kirikristof/R2D2-model/R2-D2.png

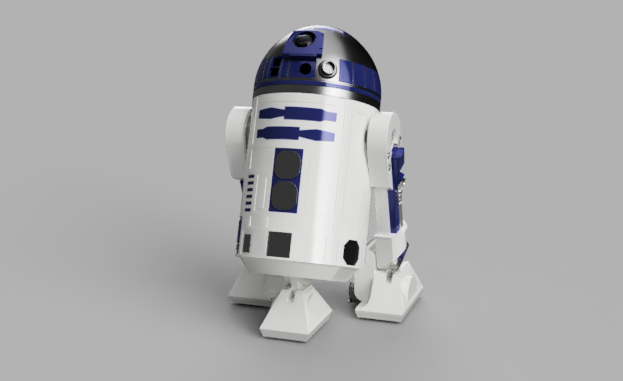
R2-D2.png
