kirikristof/R2D2-model/BOM.csv

Item Name | Qty | Price (total) (USD) | Source | Notes | Total (tax + shipping) | Link
PETG Basic white filament | 3kg | $39,87 | Bambu Lab | Filament for the main body and decorative elemets |  | https://us.store.bambulab.com/products/petg-basic?id=703099511296864281
3D printer |  |  | Borrowed | 3D printing the R2-D2 body parts
Neodimium magnet 5 x 2 mm | 40 | $10,43 | eMAG | For conecting panels |  | https://www.emag.ro/set-magneti-rotunzi-puternici-neodim-5x2-mm-argintii-20-buc-ebn2481/pd/D2R1YT3BM/
M4 x 14 mm Screw | 20 | $4,00 | Local Hardware Shop | Fastening leg joints, body, stepper motor mount and the V-groove
M4 Hex Nut | 28 |  |  | Fastening leg joints and the body
M4 x 25 mm Screw | 2 |  |  | Fastening the stepper motor
M6 x 20 mm Screw | 5 |  |  | Fastening the feet and ankles
M6 x 35 mm Screw | 2 |  |  | Fastening the feet and ankles
M6 Hex Nut | 7 |  |  | Fastening the feet and ankles
M4 Set Screw | 2 |  |  | Fastening leg wheel
M3 x 10 mm Screw | 4 |  |  | Securing the JGA motors
M3 x 16 mm Screw | 8 |  |  | Fastening the motor mount
M3 Hex Nut | 8 |  |  | Fastening the motor mount
M5 x 35 or 40 mm Screw | 6 |  |  | Fastening the Shoulders
M5 Hex Nut | 6 |  |  | Fastening the Shoulders
M4 x 12 mm Screw | 6
M3 x 10 mm Screw | 6 |  |  | Fastening the internal gear
Silver Spray Paint | 1 | Owned |  | For painting
Blue Spray Paint | 1 | $2,00 | Local Hardware Shop
Black Spray Paint | 1 | $2,00
JGA25-370 Gearmotor (6V, 176 rpm) | 2 | $21,16 | Optimus Digital | Main drive motor for legs
Raspberry Pi Pico WH RP2040 | 1 | $13,85 | eMAG | Main microcontroller for the motors and LEDs |  | https://www.emag.ro/raspberry-pi-pico-wh-rp2040-cu-wifi-si-pini-prelipiti-ai2442/pd/D9JM652BM/
28BYJ-48 Stepper Motor | 1 | $4,29 | They were in a bundle | Dome rotation |  | https://www.optimusdigital.ro/en/stepper-motors/2487-step-by-step-28byj048-5v-motor-and-uln2003-driver-green-.html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
ULN2003 Stepper motor driver | 1
Ceramic Capacitor | 2 | $2,61 | eMAG | Prevent electrical noise and sparks |  | https://www.emag.ro/condensator-ceramic-0-1uf-50v-x7r-vishay-k104k10x7rf5uh5-t275622/pd/DY9D7KYBM/
LEDs | 2 | Owned | Owned | Light in the night (Status LEDs for the dome)
Breadboard HQ (830 points) | 1 | $2,40 | Optimus Digital | Connecting electronics |  | https://www.optimusdigital.ro/en/breadboards/8-breadboard-hq-830-points.html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
Male to Female Jumper Wires | 1 Bundle | $5,52 | Optimus Digital | Connecting electronics |  | https://www.optimusdigital.ro/en/wires-with-connectors/12466-male-to-female-jumper-wires-40-pin-40cm.html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
Male to Male Jumper Wires | 1 Bundle | $1,20 | Optimus Digital |  |  | https://www.optimusdigital.ro/en/wires-with-connectors/889-set-fire-tata-tata-10p-20-cm.html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
Female to Female Jumper Wires | 40 | $2,70 | Optimus Digital |  |  | https://www.optimusdigital.ro/en/wires-with-connectors/627-fir-mama-mama-8p-de-20-cm.html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
TB6612FNG Dual Motor Driver (1 A) | 1 | $6,00 | Optimus Digital | Routes power to the drive motors so the Pico can control them |  | https://www.optimusdigital.ro/en/brushed-motor-drivers/134-tb6612fng-dual-motor-driver-1-a.html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
18650 Li-Ion Batteries | 2 | Owned | Owned | Main rechargeable power source
Li-Ion Battery Holder | 1 | $3,38 | Sierra. Ro | Housing and connecting the 18650 batteries |  | https://www.sierra.ro/cumpara/suport-acumulator-liion-format-18650-2-celule-in-serie-2150
AAA Alkaline battery | 4 | Owned | Owned | Main power source of the stepper motor
Resistor Kit 250 pcs | 1 (enough for a liftime) | $3,60 | Optimus Digital |  |  | https://www.optimusdigital.ro/en/resistors/10928-250-pcs-plusivo-resistor-kit.html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
Small Switch | 1 | Owned | Owned | Toggle electricity to leg motors
BMS PCB | 1 | $5,57 | eMAG | Prevents overcharging and overdischarging, and balances cell voltages |  | https://www.emag.ro/modul-echilibrare-si-protectie-la-incarcare-baterii-18650-20-a-2s-ai513-s176/pd/DJZKR7MBM/
Battery Holder for Small Batteries |  | Owned | Owned | Housing the AAA batteries
Assembly Consumables & Tools | 1 | Owned | Owned | Glue, sandpaper, Velcro Tape for the removable parts
Airsoft BBs / Steel bearing balls | 50-100 | Owned | Owned | Tested in V-groove for head bearing. Removed later because the mechanism turned smoother without them.
Total Price (USD): | $130,58 |  |  |  | $150,58
