kirikristof/R2D2-model/CAD/CAD_Body_Frame/Body_Frame.step

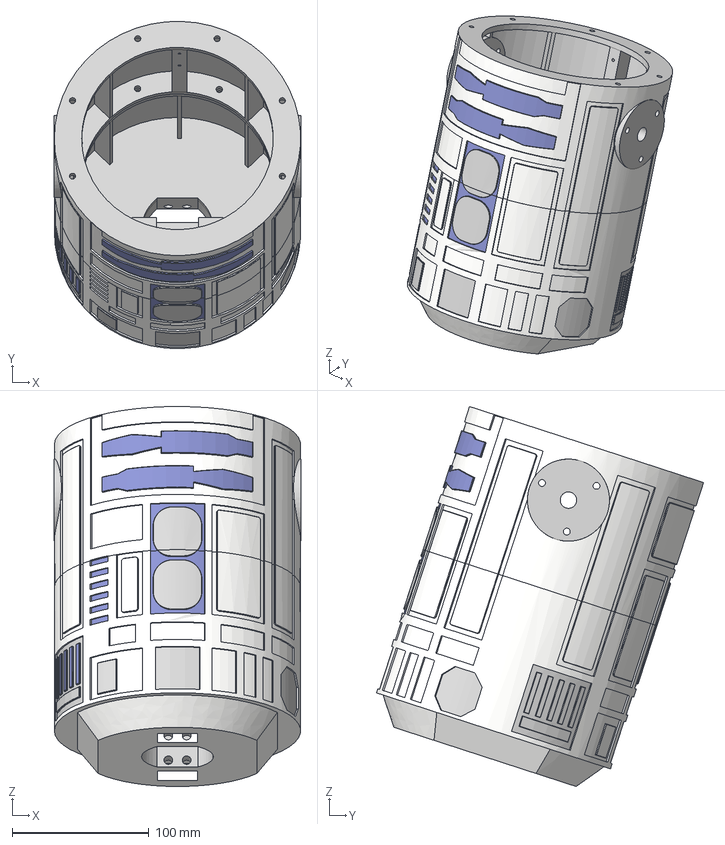
[picture p2: CAD file, 2026-09-28]
CAD/CAD_Body_Frame/Body_Frame.step
180.4 x 239.1 x 277.7 mm
