kirikristof/R2D2-model/CAD/CAD_Center_Leg/Center_Leg.step

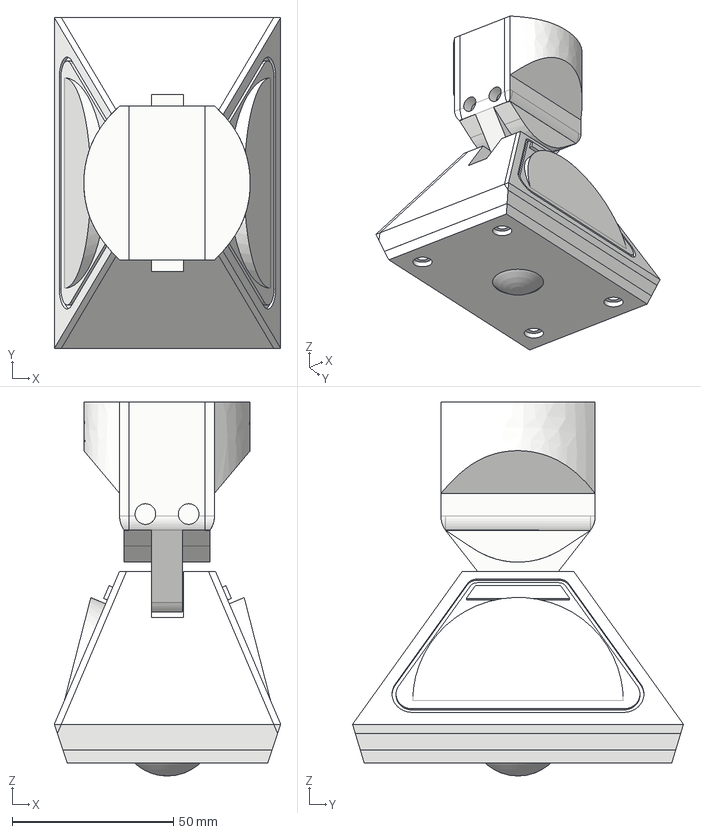
[picture p3: CAD file, 2026-09-28]
CAD/CAD_Center_Leg/Center_Leg.step
70.2 x 102.6 x 115.9 mm
