kirikristof/R2D2-model/CAD/CAD_Decorative_Details/Decorative_Details.step

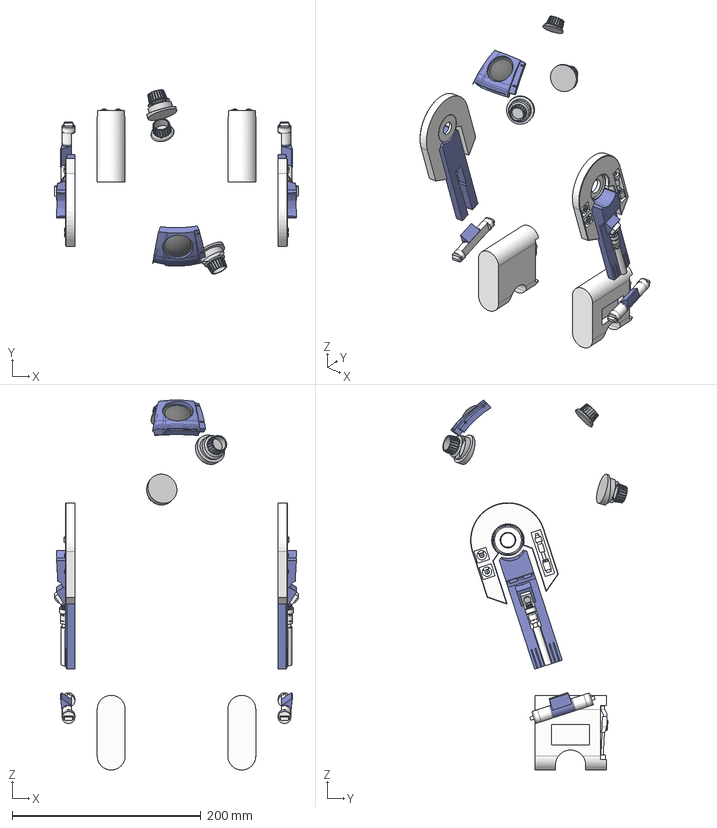
[picture p4: CAD file, 2026-09-28]
CAD/CAD_Decorative_Details/Decorative_Details.step
259.1 x 195.9 x 392.2 mm
