kirikristof/R2D2-model/CAD/CAD_Dome/Dome.step

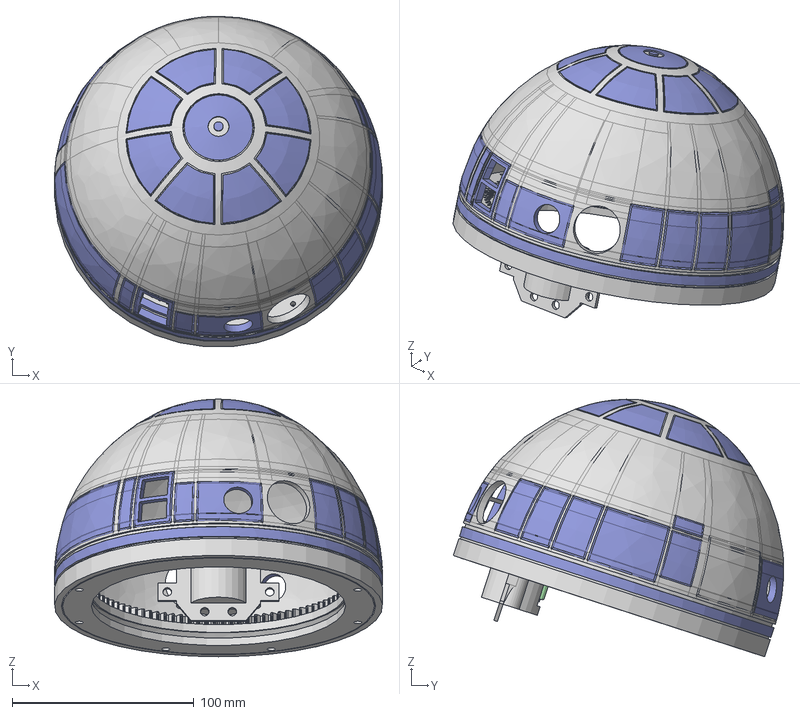
[picture p5: CAD file, 2026-10-01]
CAD/CAD_Dome/Dome.step
180.5 x 181.8 x 141.7 mm
Stepper motor 28BYJ-48 5V
