kirikristof/R2D2-model/CAD/CAD_Outer_Legs/Outer_Legs.step

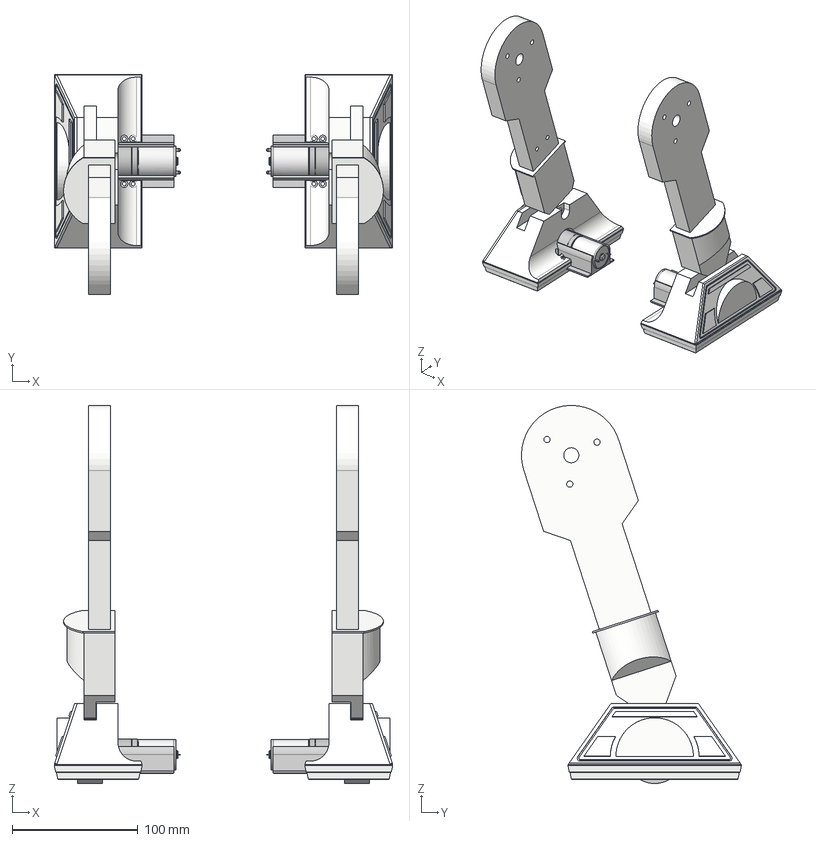
[picture p6: CAD file, 2026-10-01]
CAD/CAD_Outer_Legs/Outer_Legs.step
269.6 x 175.2 x 301.1 mm
