kirikristof/R2D2-model/(commit log)

2026-09-26 Rename BOM (2).csv to BOM.csv
    [BOM.csv]
2026-09-28 Rename R2-D2 for Stardance.step to CAD/Full.step
    [Full.step]
2026-09-30 Rename BOM - BOM.csv.csv to BOM.csv
    [BOM.csv]
2026-10-01 Rename BOM - BOM.csv (1).csv to BOM.csv
    [BOM.csv]
2026-10-16 Update README with additional resources and acknowledgments
    Added acknowledgments for additional resources related to Raspberry Pi Pico.
2026-10-16 Add wiring diagram section to README
    Added a wiring diagram image to the README.
2026-10-16 Add wiring diagram section to README
    Added wiring diagram image to the README.
2026-10-16 Add wiring diagram image to documentation
